guidoschreuder/els-esp32/hardware/els-esp32/amphenol-usb-micro-b/10118192-0002LF.step

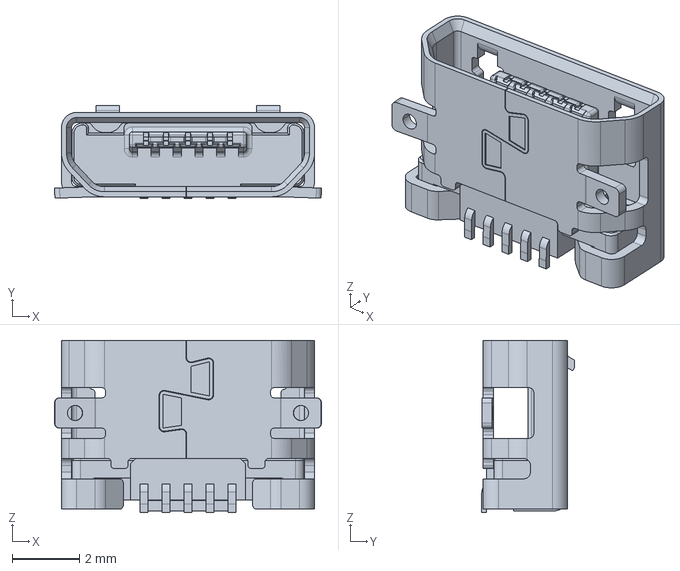
[picture p1: CAD file, 2022-09-18]
hardware/els-esp32/amphenol-usb-micro-b/10118192-0002LF.step
7.91 x 2.77 x 5.10 mm
