guidoschreuder/els-esp32/hardware/els-esp32/els-esp32.kicad_pcb

## KiCad design hardware/els-esp32/els-esp32.kicad_pcb (2022-10-03)

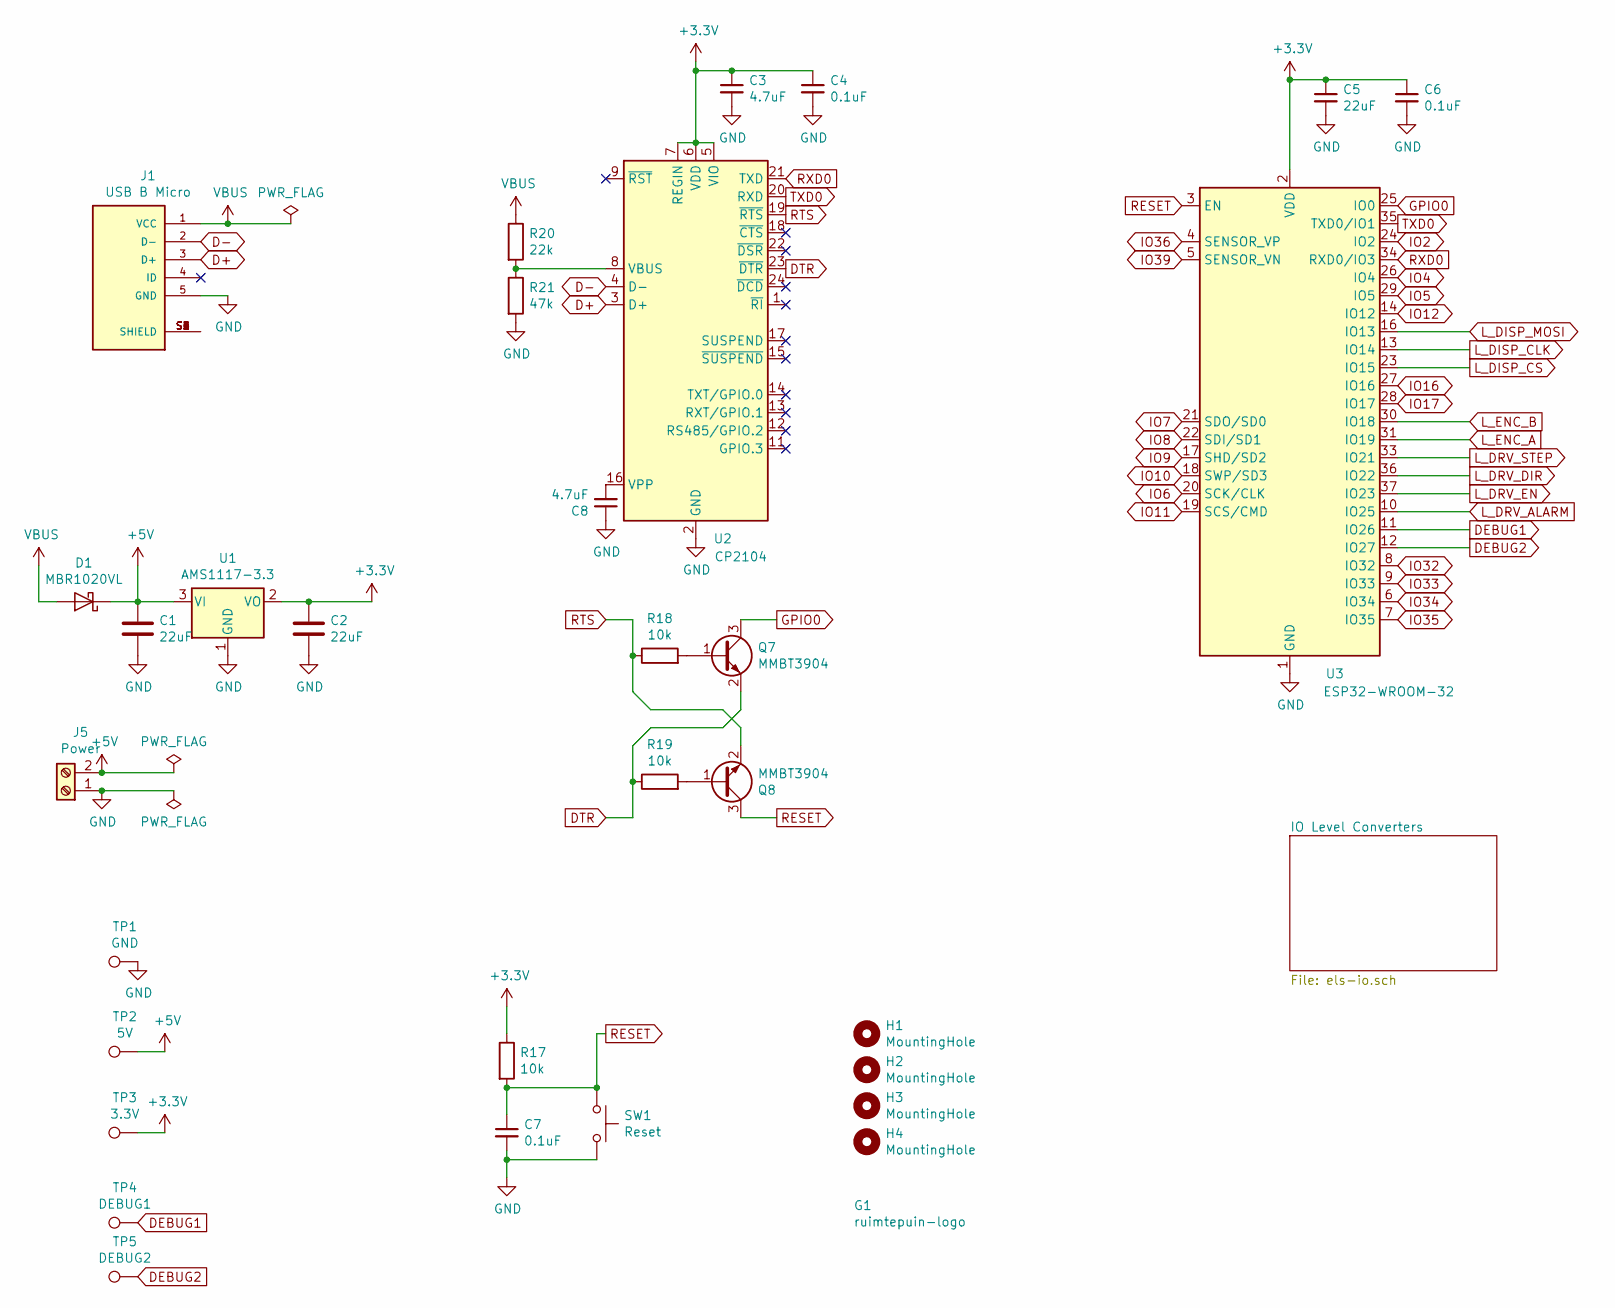
[picture p2: schematic els-esp32.sch]

Parts:
C1, C2, C5: 22uF; C_0603_1608Metric; LCSC C59461
C3, C8: 4.7uF; C_0402_1005Metric; LCSC C23733
C4, C6, C7: 0.1uF; C_0402_1005Metric; LCSC C1525
D1: MBR1020VL; D_SOD-123F
G1: ruimtepuin-logo
H1, H2, H3, H4: MountingHole; MountingHole_3mm_Pad_TopBottom
J1: USB B Micro; AMPHENOL_10118192-0002LF; PARTREV B
J5: Power; TerminalBlock_4Ucon_1x02_P3.50mm_Horizontal
Q7, Q8: MMBT3904; SOT-23; LCSC C20526
R17, R18, R19: 10k; R_0603_1608Metric; LCSC C25804
R20: 22k; R_0603_1608Metric; LCSC C25804
R21: 47k; R_0603_1608Metric; LCSC C25804
SW1: Reset; SW_SPST_EVQPE1
TP1: GND; TestPoint_THTPad_D1.5mm_Drill0.7mm
TP2: 5V; TestPoint_THTPad_D1.5mm_Drill0.7mm
TP3: 3.3V; TestPoint_THTPad_D1.5mm_Drill0.7mm
TP4: DEBUG1; TestPoint_THTPad_D1.5mm_Drill0.7mm
TP5: DEBUG2; TestPoint_THTPad_D1.5mm_Drill0.7mm
U1: AMS1117-3.3; SOT-223-3_TabPin2; LCSC C6186
U2: CP2104; QFN-24-1EP_4x4mm_P0.5mm_EP2.6x2.6mm
U3: ESP32-WROOM-32

Connections:
+3V3: C2.1, C3.1, C4.1, C5.1, C6.1, R17.1, TP3.1, U1.2 (VO), U2.5 (VIO), U2.6 (VDD), U2.7 (REGIN), U3.2 (VDD); also elsewhere on the board
+5V: C1.1, D1.1 (K), J5.2, TP2.1, U1.3 (VI); also elsewhere on the board
D+: J1.3 (D+), U2.3 (D+)
D-: J1.2 (D-), U2.4 (D-)
DEBUG1: TP4.1, U3.11 (IO26)
DEBUG2: TP5.1, U3.12 (IO27)
DTR: Q7.2 (E), R19.1, U2.23 (~DTR)
GND: C1.2, C2.2, C3.2, C4.2, C5.2, C6.2, C7.2, C8.1, J1.5 (GND), J5.1, R21.2, SW1.2, TP1.1, U1.1 (GND), U2.2 (GND), U2.25 (GND), U3.1 (GND), U3.15 (GND), U3.38 (GND), U3.39 (GND); also elsewhere on the board
GPIO0: Q7.3 (C), U3.25 (IO0)
IO2: U3.24 (IO2); also elsewhere on the board
IO4: U3.26 (IO4); also elsewhere on the board
IO5: U3.29 (IO5); also elsewhere on the board
IO6: U3.20 (SCK/CLK); also elsewhere on the board
IO7: U3.21 (SDO/SD0); also elsewhere on the board
IO8: U3.22 (SDI/SD1); also elsewhere on the board
IO9: U3.17 (SHD/SD2); also elsewhere on the board
IO10: U3.18 (SWP/SD3); also elsewhere on the board
IO11: U3.19 (SCS/CMD); also elsewhere on the board
IO12: U3.14 (IO12); also elsewhere on the board
IO16: U3.27 (IO16); also elsewhere on the board
IO17: U3.28 (IO17); also elsewhere on the board
IO32: U3.8 (IO32); also elsewhere on the board
IO33: U3.9 (IO33); also elsewhere on the board
IO34: U3.6 (IO34); also elsewhere on the board
IO35: U3.7 (IO35); also elsewhere on the board
IO36: U3.4 (SENSOR_VP); also elsewhere on the board
IO39: U3.5 (SENSOR_VN); also elsewhere on the board
L_DISP_CLK: U3.13 (IO14); also elsewhere on the board
L_DISP_CS: U3.23 (IO15); also elsewhere on the board
L_DISP_MOSI: U3.16 (IO13); also elsewhere on the board
L_DRV_ALARM: U3.10 (IO25); also elsewhere on the board
L_DRV_DIR: U3.36 (IO22); also elsewhere on the board
L_DRV_EN: U3.37 (IO23); also elsewhere on the board
L_DRV_STEP: U3.33 (IO21); also elsewhere on the board
L_ENC_A: U3.31 (IO19); also elsewhere on the board
L_ENC_B: U3.30 (IO18); also elsewhere on the board
unnamed: C8.2, U2.16 (VPP)
unnamed: J1.S1 (SHIELD), J1.S2 (SHIELD), J1.S3 (SHIELD), J1.S4 (SHIELD), J1.S5 (SHIELD), J1.S6 (SHIELD)
unnamed: Q7.1 (B), R18.2
unnamed: Q8.1 (B), R19.2
unnamed: R20.2, R21.1, U2.8 (VBUS)
RESET: C7.1, Q8.3 (C), R17.2, SW1.1, U3.3 (EN)
RTS: Q8.2 (E), R18.1, U2.19 (~RTS)
RXD0: U2.21 (TXD), U3.34 (RXD0/IO3)
TXD0: U2.20 (RXD), U3.35 (TXD0/IO1)
VBUS: D1.2 (A), J1.1 (VCC), R20.1

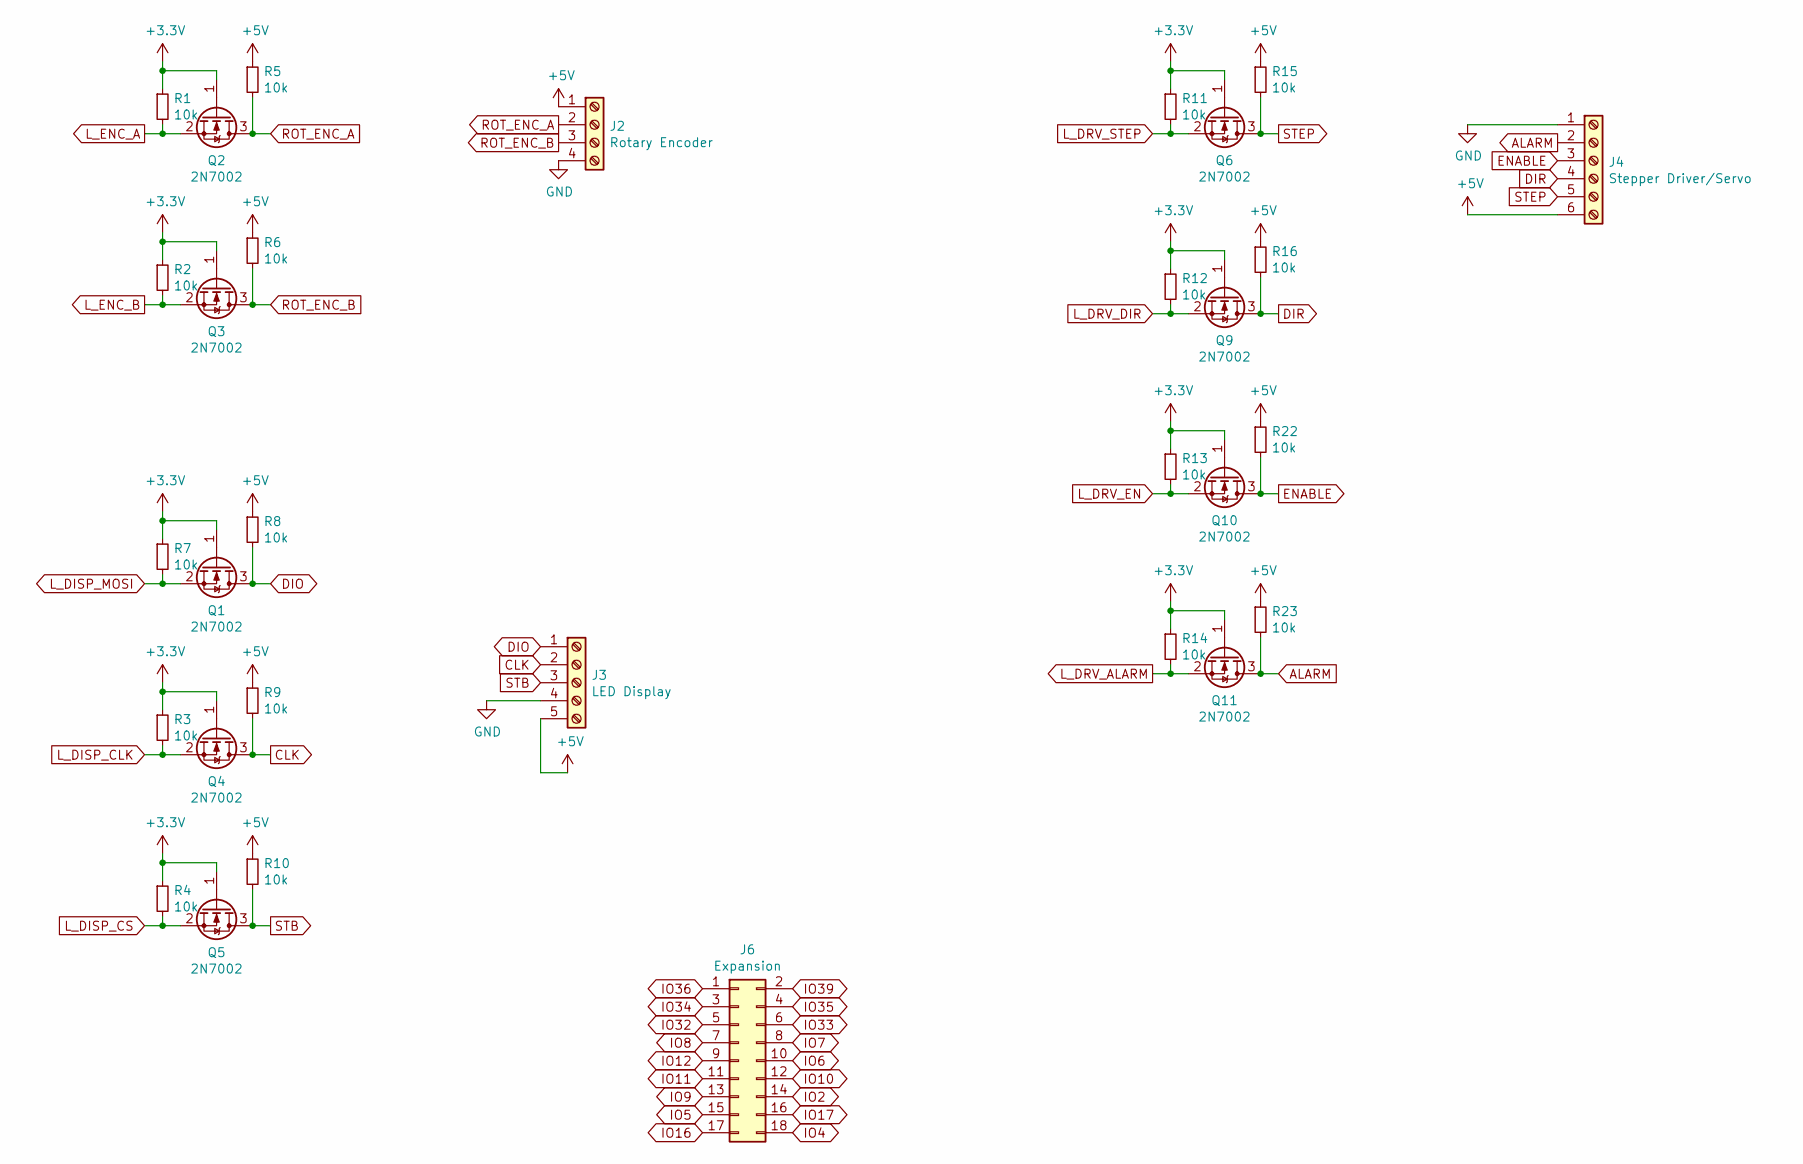
[picture p3: schematic els-io.sch]

Parts:
J2: Rotary Encoder; TerminalBlock_4Ucon_1x04_P3.50mm_Horizontal
J3: LED Display; PinHeader_1x05_P2.54mm_Vertical
J4: Stepper Driver/Servo; TerminalBlock_4Ucon_1x06_P3.50mm_Horizontal
J6: Expansion; PinHeader_2x09_P2.54mm_Vertical
Q1, Q2, Q3, Q4, Q5, Q6, Q9, Q10, Q11: 2N7002; SOT-23; LCSC C8545
R1, R2, R3, R4, R5, R6, R7, R8, R9, R10, R11, R12, R13, R14, R15, R16, R22, R23: 10k; R_0603_1608Metric; LCSC C25804

Connections:
+3V3: Q1.1 (G), Q2.1 (G), Q3.1 (G), Q4.1 (G), Q5.1 (G), Q6.1 (G), Q9.1 (G), Q10.1 (G), Q11.1 (G), R1.1, R2.1, R3.1, R4.1, R7.1, R11.1, R12.1, R13.1, R14.1; also elsewhere on the board
+5V: J2.1, J3.5, J4.6, R5.1, R6.1, R8.1, R9.1, R10.1, R15.1, R16.1, R22.1, R23.1; also elsewhere on the board
ALARM: J4.2, Q11.3 (D), R23.2
CLK: J3.2, Q4.3 (D), R9.2
DIO: J3.1, Q1.3 (D), R8.2
DIR: J4.4, Q9.3 (D), R16.2
ENABLE: J4.3, Q10.3 (D), R22.2
GND: J2.4, J3.4, J4.1; also elsewhere on the board
IO2: J6.14; also elsewhere on the board
IO4: J6.18; also elsewhere on the board
IO5: J6.15; also elsewhere on the board
IO6: J6.10; also elsewhere on the board
IO7: J6.8; also elsewhere on the board
IO8: J6.7; also elsewhere on the board
IO9: J6.13; also elsewhere on the board
IO10: J6.12; also elsewhere on the board
IO11: J6.11; also elsewhere on the board
IO12: J6.9; also elsewhere on the board
IO16: J6.17; also elsewhere on the board
IO17: J6.16; also elsewhere on the board
IO32: J6.5; also elsewhere on the board
IO33: J6.6; also elsewhere on the board
IO34: J6.3; also elsewhere on the board
IO35: J6.4; also elsewhere on the board
IO36: J6.1; also elsewhere on the board
IO39: J6.2; also elsewhere on the board
L_DISP_CLK: Q4.2 (S), R3.2; also elsewhere on the board
L_DISP_CS: Q5.2 (S), R4.2; also elsewhere on the board
L_DISP_MOSI: Q1.2 (S), R7.2; also elsewhere on the board
L_DRV_ALARM: Q11.2 (S), R14.2; also elsewhere on the board
L_DRV_DIR: Q9.2 (S), R12.2; also elsewhere on the board
L_DRV_EN: Q10.2 (S), R13.2; also elsewhere on the board
L_DRV_STEP: Q6.2 (S), R11.2; also elsewhere on the board
L_ENC_A: Q2.2 (S), R1.2; also elsewhere on the board
L_ENC_B: Q3.2 (S), R2.2; also elsewhere on the board
ROT_ENC_A: J2.2, Q2.3 (D), R5.2
ROT_ENC_B: J2.3, Q3.3 (D), R6.2
STB: J3.3, Q5.3 (D), R10.2
STEP: J4.5, Q6.3 (D), R15.2

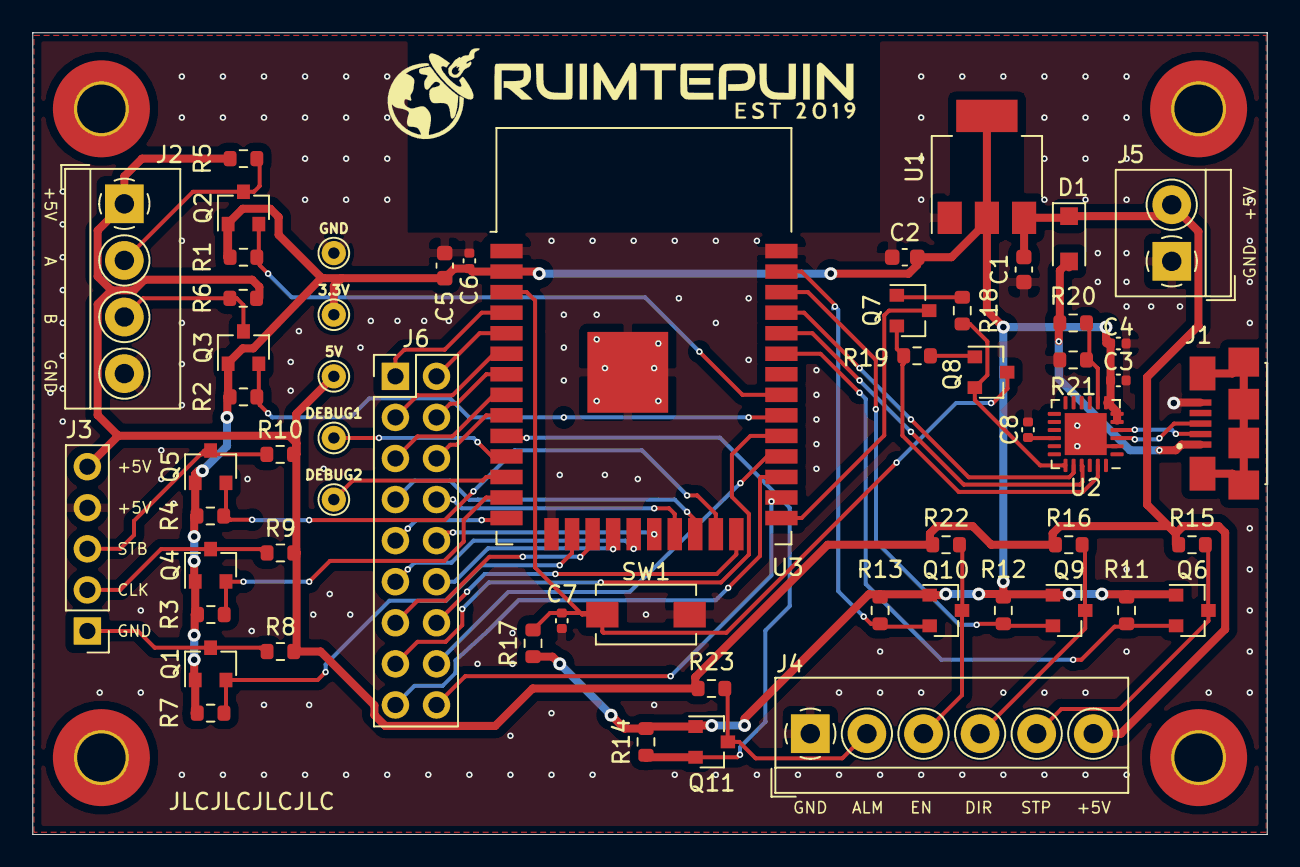
[picture p4: board els-esp32.kicad_pcb from above]

Board: 2 copper layers, 76.3 x 49.6 mm, 63 parts (0 on the bottom side), 55 nets.
