guidoschreuder/els-esp32/els-esp32/src/StepperDrive.h

// Clough42 Electronic Leadscrew
// https://github.com/clough42/electronic-leadscrew
//
// MIT License
//
// Copyright (c) 2019 James Clough
//
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

#ifndef __STEPPERDRIVE_H
#define __STEPPERDRIVE_H

#include "Configuration.h"
#include <stdint.h>
#include <driver/gpio.h>
#include <driver/rmt.h>

#define GPIO_SET(pin) gpio_set_level((gpio_num_t)pin, 1)
#define GPIO_CLEAR(pin) gpio_set_level((gpio_num_t)pin, 0)
#define GPIO_GET(pin) gpio_get_level((gpio_num_t)pin)

#ifdef INVERT_DIRECTION_PIN
#define GPIO_SET_DIRECTION GPIO_CLEAR(DIRECTION_GPIO)
#define GPIO_CLEAR_DIRECTION GPIO_SET(DIRECTION_GPIO)
#else
#define GPIO_SET_DIRECTION GPIO_SET(DIRECTION_GPIO)
#define GPIO_CLEAR_DIRECTION GPIO_CLEAR(DIRECTION_GPIO)
#endif

#ifdef INVERT_ENABLE_PIN
#define GPIO_SET_ENABLE GPIO_CLEAR(ENABLE_GPIO)
#define GPIO_CLEAR_ENABLE GPIO_SET(ENABLE_GPIO)
#else
#define GPIO_SET_ENABLE GPIO_SET(ENABLE_GPIO)
#define GPIO_CLEAR_ENABLE GPIO_CLEAR(ENABLE_GPIO)
#endif

#ifdef INVERT_ALARM_PIN
#define GPIO_GET_ALARM (GPIO_GET(ALARM_GPIO) == 0)
#else
#define GPIO_GET_ALARM (GPIO_GET(ALARM_GPIO) != 0)
#endif


class StepperDrive
{
private:
    //
    // Current position of the motor, in steps
    //
    int64_t currentPosition;

    //
    // Desired position of the motor, in steps
    //
    int64_t desiredPosition;

    //
    // Is the drive enabled?
    //
    volatile bool enabled;

    rmt_item32_t pulses[MAX_BUFFERED_STEPS];

public:
    StepperDrive();
    void initHardware(void);

    void setDesiredPosition(int64_t);
    void setCurrentPosition(int64_t);

    bool checkStepBacklog();

    void setEnabled(bool);

    bool isAlarm();

    void ISR(void);
};

inline void StepperDrive :: setDesiredPosition(int64_t position)
{
    this->desiredPosition = position;
}

inline void StepperDrive :: setCurrentPosition(int64_t position)
{
    this->currentPosition = position;
}

inline bool StepperDrive :: checkStepBacklog()
{
    if( abs(this->desiredPosition - this->currentPosition) > MAX_BUFFERED_STEPS ) {
        setEnabled(false);
        return true;
    }
    return false;
}

inline void StepperDrive :: setEnabled(bool enabled)
{
    this->enabled = enabled;
    if( this->enabled ) {
        GPIO_SET_ENABLE;
    }
    else
    {
        GPIO_CLEAR_ENABLE;
    }
}

inline bool StepperDrive :: isAlarm()
{
#ifdef USE_ALARM_PIN
    return GPIO_GET_ALARM;
#else
    return false;
#endif
}

#define MIN(a,b) (a > b ? b : a)

inline void StepperDrive :: ISR(void)
{
    if(enabled) {
        int64_t pulse_cnt = this->desiredPosition - this->currentPosition;
        if (pulse_cnt == 0) {
            return;
        }

        if (pulse_cnt > 0) {
            pulse_cnt = MIN(pulse_cnt, MAX_BUFFERED_STEPS);
            this->currentPosition += pulse_cnt;
            GPIO_CLEAR_DIRECTION;
        } else {
            pulse_cnt = MIN(-pulse_cnt, MAX_BUFFERED_STEPS);
            this->currentPosition -= pulse_cnt;
            GPIO_SET_DIRECTION;
        }

        // if RMT channel is still busy then return and wait for next cycle
        // TODO: this seems to be faster than `rmt_wait_tx_done` but might need further testing
        rmt_channel_status_result_t res;
        rmt_get_channel_status(&res);
        if (res.status[STEPPER_RMT_CHANNEL] == rmt_channel_status_t::RMT_CHANNEL_BUSY) {
            return;
        }

        ESP_ERROR_CHECK(rmt_write_items(STEPPER_RMT_CHANNEL, &this->pulses[0], pulse_cnt, false));

    } else {
        // not enabled; just keep current position in sync
        this->currentPosition = this->desiredPosition;
    }
}

#endif // __STEPPERDRIVE_H
