guidoschreuder/els-esp32/encoder-sim/src/DelayTable.h

const uint16_t delayTable[] PROGMEM = {
244,
235,
227,
219,
212,
205,
199,
193,
187,
182,
177,
172,
168,
163,
159,
155,
152,
148,
145,
142,
139,
136,
133,
130,
127,
125,
123,
120,
118,
116,
114,
112,
110,
108,
106,
105,
103,
101,
100,
98,
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

};
