guidoschreuder/els-esp32/(commit log)

2022-06-30 Port encoder-sim to platformio
2022-07-03 UNTESTED: ported most of the code, except SPI
    [Configuration.h]
2022-07-03 Add upload_port for encoder-sim
2022-07-05 Fix masks for gpio setup
    [Debug.cpp, StepperDrive.cpp]
2022-07-05 Use correct pin for debug2
    [Debug.h]
2022-07-05 UNTESTED: First stab at controlling display, SPIBus.* files removed as it translated poorly to ESP32, ControlPanel.c directly uses SPI
    [Configuration.h]
2022-07-05 renormalize all source files
    [Configuration.h]
2022-07-05 Added comment about limitation of current timer setup
2022-07-06 Set integer math as default
    [Configuration.h]
2022-07-06 Store all encoder positions as int64
2022-07-06 Move to espressif32@5.0.0 and pin the version in platformio.ini
2022-07-08 Add macro to cleanup leds definitions
2022-07-08 Remove unused CPU_CLOCK definitions
    [Configuration.h]
2022-07-09 Use hardware timer
    [Configuration.h]
2022-07-14 Reduce lower bounds on STEPPER_CYCLE_US and correct error message
    [SanityCheck.h]
2022-07-15 use RMT for driving step pin
    [Configuration.h]
2022-07-16 Simplify logic in StepperDrive
2022-07-17 Remove additional interrupt as it was not the cause of excessive backlog
2022-07-18 Add config option for core service CPU affinity
    [Configuration.h]
2022-07-20 Use ESP32Encoder through lib_deps
2022-07-20 Pin ISR service to same core as core-service
2022-07-20 Re-enable panic now that concurrency issue is resolved
    [StepperDrive.h]
2022-07-20 Declare enabled as volatile since it might be written by another thread/core
2022-07-22 Point to main branch in modified ESP32Encoder library
2022-07-22 remove temporary debug code for concurrency issue
    [Core.h]
2022-07-23 Use initializer list for stepper constructor
2022-07-23 Messed up setting the state of the stepper
2022-09-18 First version of board
    [10118192-0002LF.step, els-esp32.kicad_pcb, els-esp32.sch, els-io.sch]
2022-10-02 minor layout
    [els-esp32.kicad_pcb, els-esp32.sch]
2022-10-03 Fixed hardware bug, one transistor was reversed
    [els-esp32.kicad_pcb, els-esp32.sch]
